malfalf/BenchBudEE/BenchBudEE/BOM/BenchBudEE_BOM_Actives.xls

Sheet: Cost Target
Part Index | Section | Device | 2nd | MFG | MFG Part Number | Quantity | 1 piece price | DK Link |  | 1 | 100 | 1000
1 | Current/Fan | Power/Mode FET | y | Alpha And Omega | AOD476 | 2 | $0.54 | http://www.digikey.com/product-detail/en/AOD476/785-1112-1-ND/1856055
1 | Current/Fan | Power/Mode FET | y | Fairchild Semiconductor | FDD6630A | 2 | $0.84 | http://www.findchips.com/search/FDD6630A
2 | Current/Fan | Signal FET | y | Diodes Inc | DMN65D8L-7 | 1 | $0.06 | http://www.digikey.com/product-detail/en/DMN65D8L-7/DMN65D8L-7DICT-ND/3677916
2 | Current/Fan | Signal FET | y | ST Micro | 2N7002 | 1 | $0.04 | http://www.findchips.com/search/2N7002#2953375
3 | Current/Fan | PTC |  | TE Connectivity | MINISMDC050F-2 | 1 | $0.31 | http://www.digikey.com/product-detail/en/MINISMDC050F-2/MINISMDC050FCT-ND/1045862
4 | Current/Fan | MCP4801 |  | Microchip | MCP4801-E/SN |  | $1.36 | http://www.digikey.com/product-detail/en/MCP4801-E%2FSN/MCP4801-E%2FSN-ND/2332805
5 | Interface | 3 pin 5.0mm Terminal Block |  | Phoenix Contact | 1935174 | 1 | $0.50 | http://www.digikey.com/product-detail/en/1935174/277-1578-ND/568615 | Power Modify | $9.64 | $2.08 | $2.55
6 | Interface | 12 input 3.5 mm Terminal Block | y | On Shore | OSTTE120104 | 1 | $1.57 | http://www.digikey.com/product-detail/en/OSTTE120104/ED2737-ND/2351813
6 | Interface | 12 input 3.5 mm Terminal Block | y | Phoenix Contact | 1984714 | 1 | $2.20 | http://www.findchips.com/search/1984714
7 | Interface | ATX connector |  | Molex | 39-30-1240 | 1 | $3.56 | http://www.mouser.com/ProductDetail/Molex/39-30-1240/ | Slush | $3.19 | $30.62 | $300.77
8 | Interface | 36 pin Breakaway | y | Molex | 22284360 | 1 | $0.89 | http://www.digikey.com/product-detail/en/0022284360/WM50014-36-ND/313821
9 | LED | AP5726 |  | Diodes Inc | AP5726WG-7 | 1 | $0.64 | http://www.digikey.com/product-detail/en/AP5726WG-7/AP5726WG-7DICT-ND/2639342
10 | LED | B0540WS-7 |  | Diodes Inc | B0540WS-7 | 1 | $0.45 | http://www.digikey.com/product-search/en?x=0&y=0&lang=en&site=us&KeyWords=B0540WS
11 | LED | NR4012T220M |  | Toiyo Yuden | NR4012T220M | 1 | $0.40 | http://www.digikey.com/product-detail/en/NR4012T220M/587-1660-1-ND/1008275
12 | Power Modify | 10V linear | y | On Semiconductor | LM317TG | 2 | $0.57 | http://www.digikey.com/product-detail/en/LM317TG/LM317TGOS-ND/918508
12 | Power Modify | 10V linear | y | On Semiconductor | LM317MTG | 2 | $0.64 | http://www.findchips.com/search/LM317MTG
13 | Power Modify | -10V linear | y | Fairchild Semiconductor | LM337TFS | 2 | $0.71 | http://www.digikey.com/product-detail/en/LM337T/LM337TFS-ND/458683
13 | Power Modify | -10V linear | y | Fairchild Semiconductor | LM337BTG | 2 | $0.71 | http://www.findchips.com/search/LM337BTG
16 | Power Modify | Potentiometer | y* | Panasonic Electric Components | EVU-E3KFK4B53 | 2 | $1.00 | http://www.digikey.com/product-detail/en/EVU-E3KFK4B53/P3W1502-ND/243676
16 | Power Modify | Potentiometer | y* | Bournes Inc | 3310C-1-502L | 2 | $2.35 | http://www.findchips.com/search/3310C-1-502L
17 | Power Modify | Diode |  | Diodes Inc | S1M-13-F | 4 | $0.15 | http://www.digikey.com/product-detail/en/S1M-13-F/S1M-FDICT-ND/804909
18 | Protection/Filtering | PTC |  | TE Connectivity | MINISMDC050F-2 | 4 | $0.31 | www.digikey.com/product-detail/en/MINISMDC050F-2/MINISMDC050FCT-ND/1045862
19 | Protection/Filtering | Inductor |  | Bournes Inc | CM322522-220KL | 2 | $0.22 | http://www.digikey.com/product-detail/en/CM322522-220KL/CM322522-220KLCT-ND/3437950
20 | Protection/Filtering | Switch |  | C&K Components | OS102011MA1QN1 | 1 | $0.35 | http://www.digikey.com/product-detail/en/OS102011MA1QN1/CKN9559-ND/1981430
21 | Relay | SPDT | y | TE Connectivity | 1461069-5 | 1 | $1.15 | http://www.digikey.com/product-detail/en/1461069-5/PB1321-ND/3318145 | LED | $1.49 | $0.92 | $0.52
21 | Relay | SPDT | y | OMRON | G5LA-1 12DC | 1 | $0.70 | http://www.findchips.com/search/G5LA-1%2012DC
22 | Relay | NPN (MMBT3904) |  | Diodes Inc | MMBT3904-7-F | 1 | $0.12 | http://www.digikey.com/product-detail/en/MMBT3904-7-F/MMBT3904-FDICT-ND/815727
23 | Relay | Opto | y | Lite On Ince | LTV-816S | 1 | $0.39 | www.digikey.com/product-detail/en/LTV-816S/160-1361-5-ND/385831
23 | Relay | Opto | y | Lite On Ince | ACPL-217-500E | 1 |  | http://www.findchips.com/search/ACPL-217-500E
24 | Relay | B130-13-F |  | Diodes Inc | B130-13-F | 1 | $0.43 | http://www.digikey.com/product-detail/en/B130-13-F/B130-FDICT-ND/815318
25 | Relay | LED | y | OSRAM Opto | LG Q971-KN-1 | 1 | $0.08 | http://www.digikey.com/product-detail/en/LG%20Q971-KN-1/475-1409-1-ND/1802597
25 | Relay | LED | y | Kingbright | KP-1608CGCK | 1 | $0.16 | http://www.findchips.com/search/KP-1608CGCK
26 | TC/Analog | MCP3901 |  | Microchip | MCP3901A0-I/SS | 1 | $2.39 | http://www.digikey.com/product-detail/en/MCP3901A0-I%2FSS/MCP3901A0-I%2FSS-ND/2179119 | Total | $14.84 | $5.79 | $6.62
27 | TC/Analog | OPA4170 | y | Texas Instruments | OPA4170AIDR | 1 | $2.58 | http://www.digikey.com/product-detail/en/OPA4170AIDR/296-29664-1-ND/2762167 | TC/Analog | $2.39 | $1.51 | $1.51
27 | TC/Analog | OPA4170 | y | Texas Instruments | OPA4170AID | 1 | $2.58 | http://www.findchips.com/search/OPA4170AID
28 | TC/Analog | LMT84 |  | Texas Instruments | LMT84DCKT | 1 | $0.73 | http://www.digikey.com/product-detail/en/LMT84DCKT/296-35727-2-ND/3974441 | Current/Fan | $1.45 | $0.94 | $0.57
29 | TC/Analog | .1% 20K, 1206 | y | Susumu | RG3216P-2002-B-T1 | 4 | $0.65 | http://www.digikey.com/product-search/en?v=408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 | Relay | $2.17 | $1.21 | $0.82
29 | TC/Analog | .1% 10K, 1206 | y | Susumu | CRT1206-BY-1002ELF | 4 |  | http://www.findchips.com/search/CRT1206-BY-1002ELF
30 | TC/Analog | Shunt/Jumper |  | 3M | 969102-0000-DA | 3 | $0.10 | http://www.digikey.com/product-detail/en/969102-0000-DA/3M9580-ND/2071621 | General | $0.00 | $0.00 | $0.00
31 | Power Modify | Heatsink | y | Assmann | V8508H | 2 | $0.58 | http://www.digikey.com/product-search/en?vendor=0&keywords=V8508H
31 | Power Modify | Heatsink | y | Multicomp | MC33282 | 2 | $1.25 | http://www.findchips.com/search/MC33282

Sheet: Design Constraints
Index | Constraint | Reason
1 | Parts not too expensive in low quantity
2 | Solderable components
3 | Multiple parts for the footprint/available parts | Worldwide people
4 | No Throughhole
5 | Low lead time | Time constrained
6 | No more than a 4 layer board, prefer 2
7 | Board no bigger than 3x4
8 | Board can be stackable
9 | Maintain Arduino constraints (clock,power,pins)
