malfalf/BenchBudEE/BenchBudEE/BenchBudEE.kicad_pcb

## KiCad design BenchBudEE/BenchBudEE.kicad_pcb (2014-03-31)

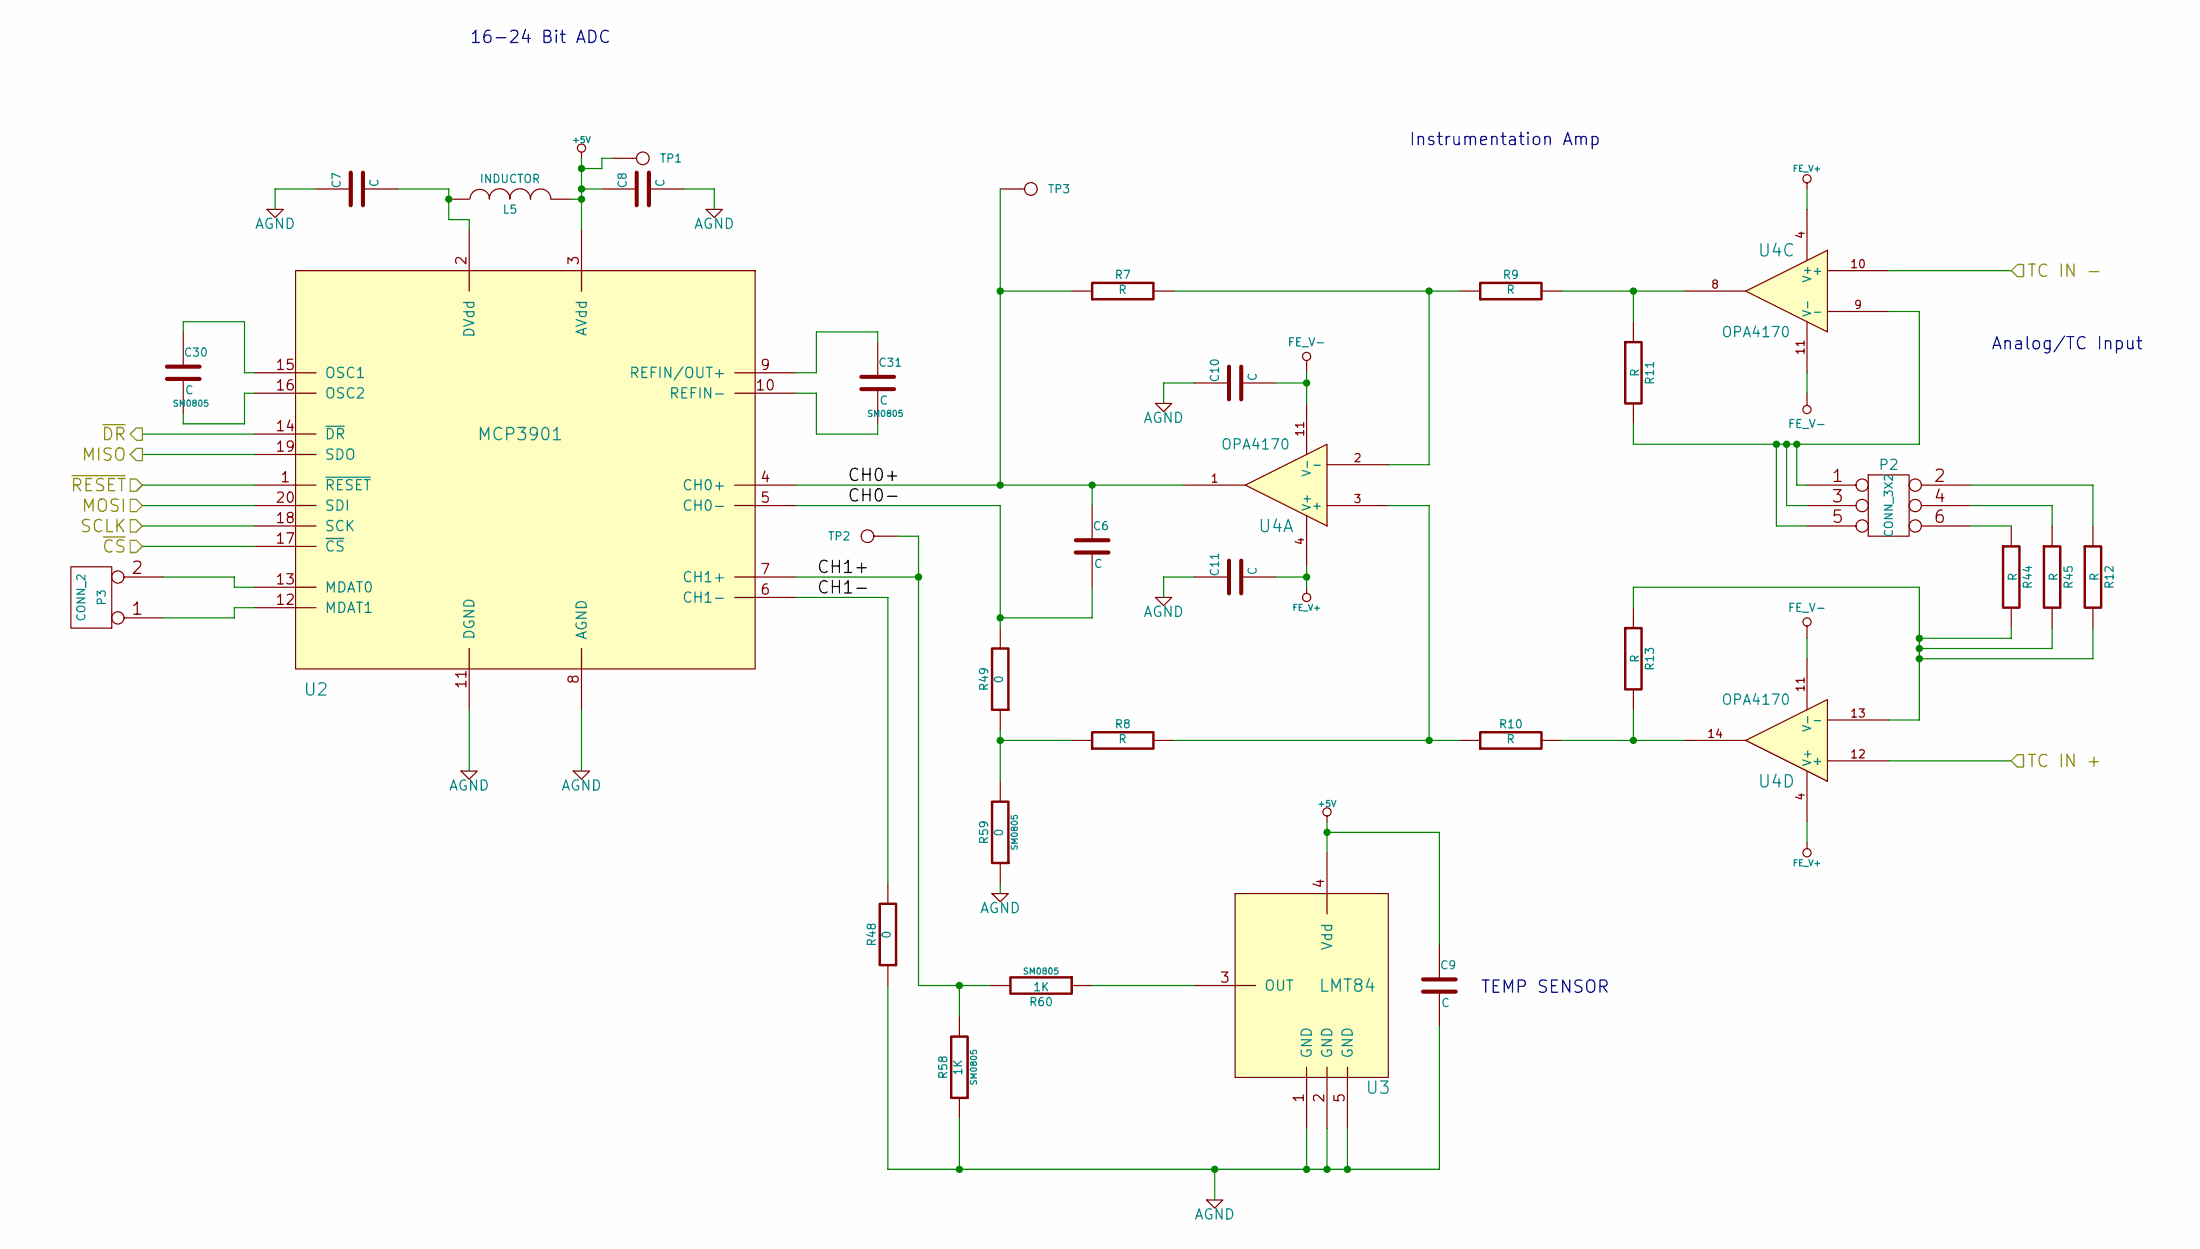
[picture p1: schematic Thermocouple.sch]

Parts:
C6, C7, C8, C9, C10, C11: C
C30, C31: C; SM0805
L5: INDUCTOR
P2: CONN_3X2
P3: CONN_2
R7, R8, R9, R10, R11, R12, R13, R44, R45: R
R48, R49: 0
R58, R60: 1K; SM0805
R59: 0; SM0805
TP1: 5V
TP2: CH1+
TP3: CH0+
U2: MCP3901
U3: LMT84
U4: OPA4170

Connections:
+5V: C8.1, C9.1, L5.2, TP1.1, U2.3 (AVdd), U3.4 (Vdd); also elsewhere on the board
/Arduino/MISO: U2.19 (SDO); also elsewhere on the board
/Arduino/MOSI: U2.20 (SDI); also elsewhere on the board
/Arduino/SCLK: U2.18 (SCK); also elsewhere on the board
/Arduino/~ADC_CS: U2.17 (~CS); also elsewhere on the board
/Arduino/~DR: U2.14 (~DR); also elsewhere on the board
/Arduino/~RESET: U2.1 (~RESET); also elsewhere on the board
/Thermocouple/CH0+: C6.1, R7.1, TP3.1, U2.4 (CH0+), U4.1
/Thermocouple/CH0-: C6.2, R49.2, U2.5 (CH0-)
/Thermocouple/CH1+: R58.2, R60.2, TP2.1, U2.7 (CH1+)
/Thermocouple/CH1-: R48.2, U2.6 (CH1-)
/Thermocouple/TC IN +: U4.12 (+); also elsewhere on the board
/Thermocouple/TC IN -: U4.10 (+); also elsewhere on the board
AGND: C7.1, C8.2, C9.2, C10.1, C11.1, R48.1, R58.1, R59.1, U2.8 (AGND), U2.11 (DGND), U3.1 (GND), U3.2 (GND), U3.5 (GND); also elsewhere on the board
FE_V+: C11.2, U4.4 (V+); also elsewhere on the board
FE_V-: C10.2, U4.11 (V-); also elsewhere on the board
unnamed: C7.2, L5.1, U2.2 (DVdd)
unnamed: C30.1, U2.15 (OSC1)
unnamed: R60.1, U3.3 (OUT)
unnamed: C30.2, U2.16 (OSC2)
unnamed: C31.2, U2.10 (REFIN-)
unnamed: P2.4, R45.1
unnamed: P2.6, R44.1
unnamed: R8.2, R10.1, U4.3 (+)
unnamed: R7.2, R9.1, U4.2 (-)
unnamed: P2.2, R12.1
unnamed: R9.2, R11.1, U4.8
unnamed: R10.2, R13.2, U4.14
unnamed: P3.2 (PM), U2.13 (MDAT0)
unnamed: P3.1, U2.12 (MDAT1)
unnamed: C31.1, U2.9 (REFIN/OUT+)
unnamed: R8.1, R49.1, R59.2
unnamed: R12.2, R13.1, R44.2, R45.2, U4.13 (-)
unnamed: P2.1, P2.3, P2.5, R11.2, U4.9 (-)

Notes on the sheet:
Analog/TC Input
Instrumentation Amp
16-24 Bit ADC
TEMP SENSOR

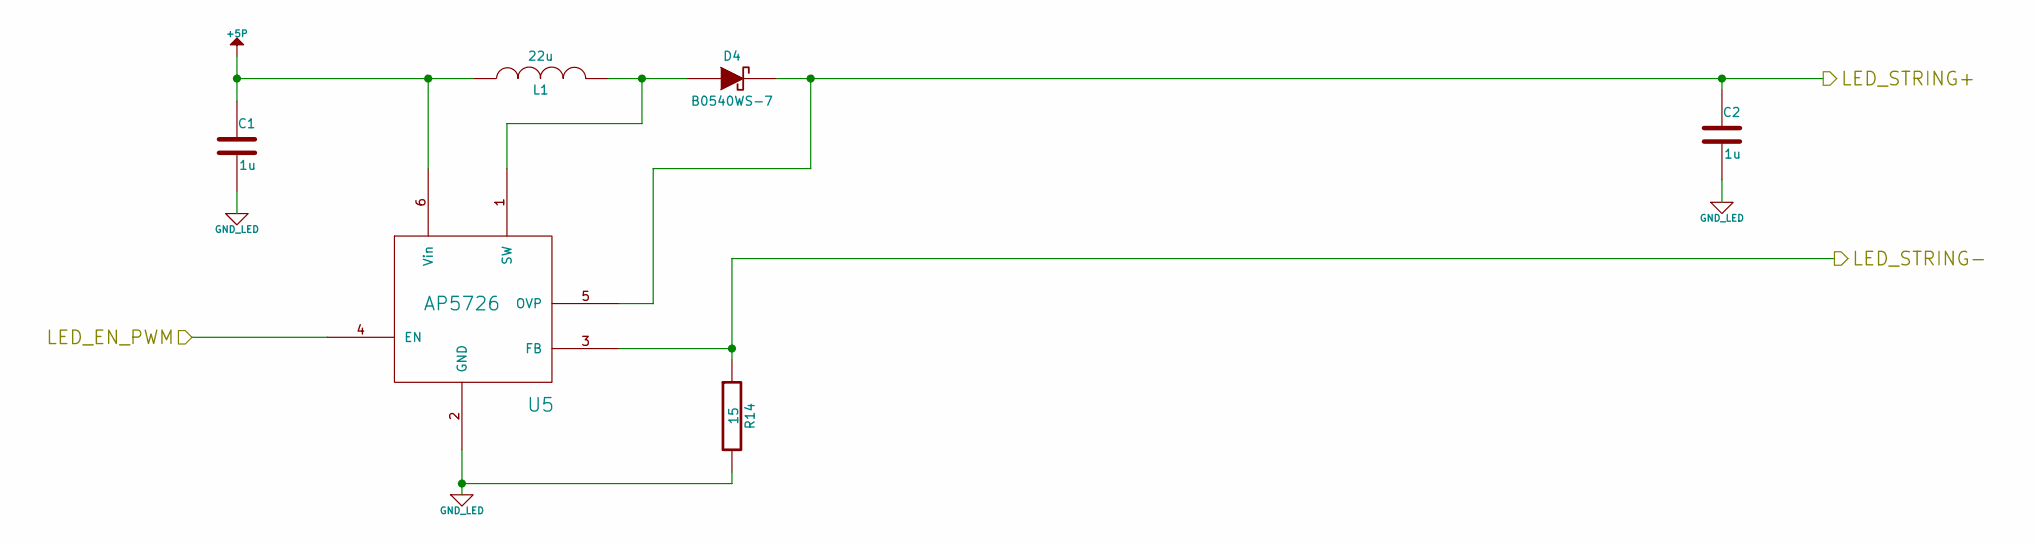
[picture p2: schematic LED_Driver.sch]

Parts:
C1, C2: 1u
D4: B0540WS-7
L1: 22u; MFG Part Number NR4012T220M
R14: 15
U5: AP5726

Connections:
+5P: C1.1, L1.1, U5.6 (Vin); also elsewhere on the board
/Arduino/LED_EN_PWM: U5.4 (EN); also elsewhere on the board
/LED_Driver/LED_STRING+: C2.1, D4.2 (K), U5.5 (OVP); also elsewhere on the board
/LED_Driver/LED_STRING-: R14.1, U5.3 (FB); also elsewhere on the board
GND_LED: C1.2, C2.2, R14.2, U5.2 (GND); also elsewhere on the board
unnamed: D4.1 (A), L1.2, U5.1 (SW)

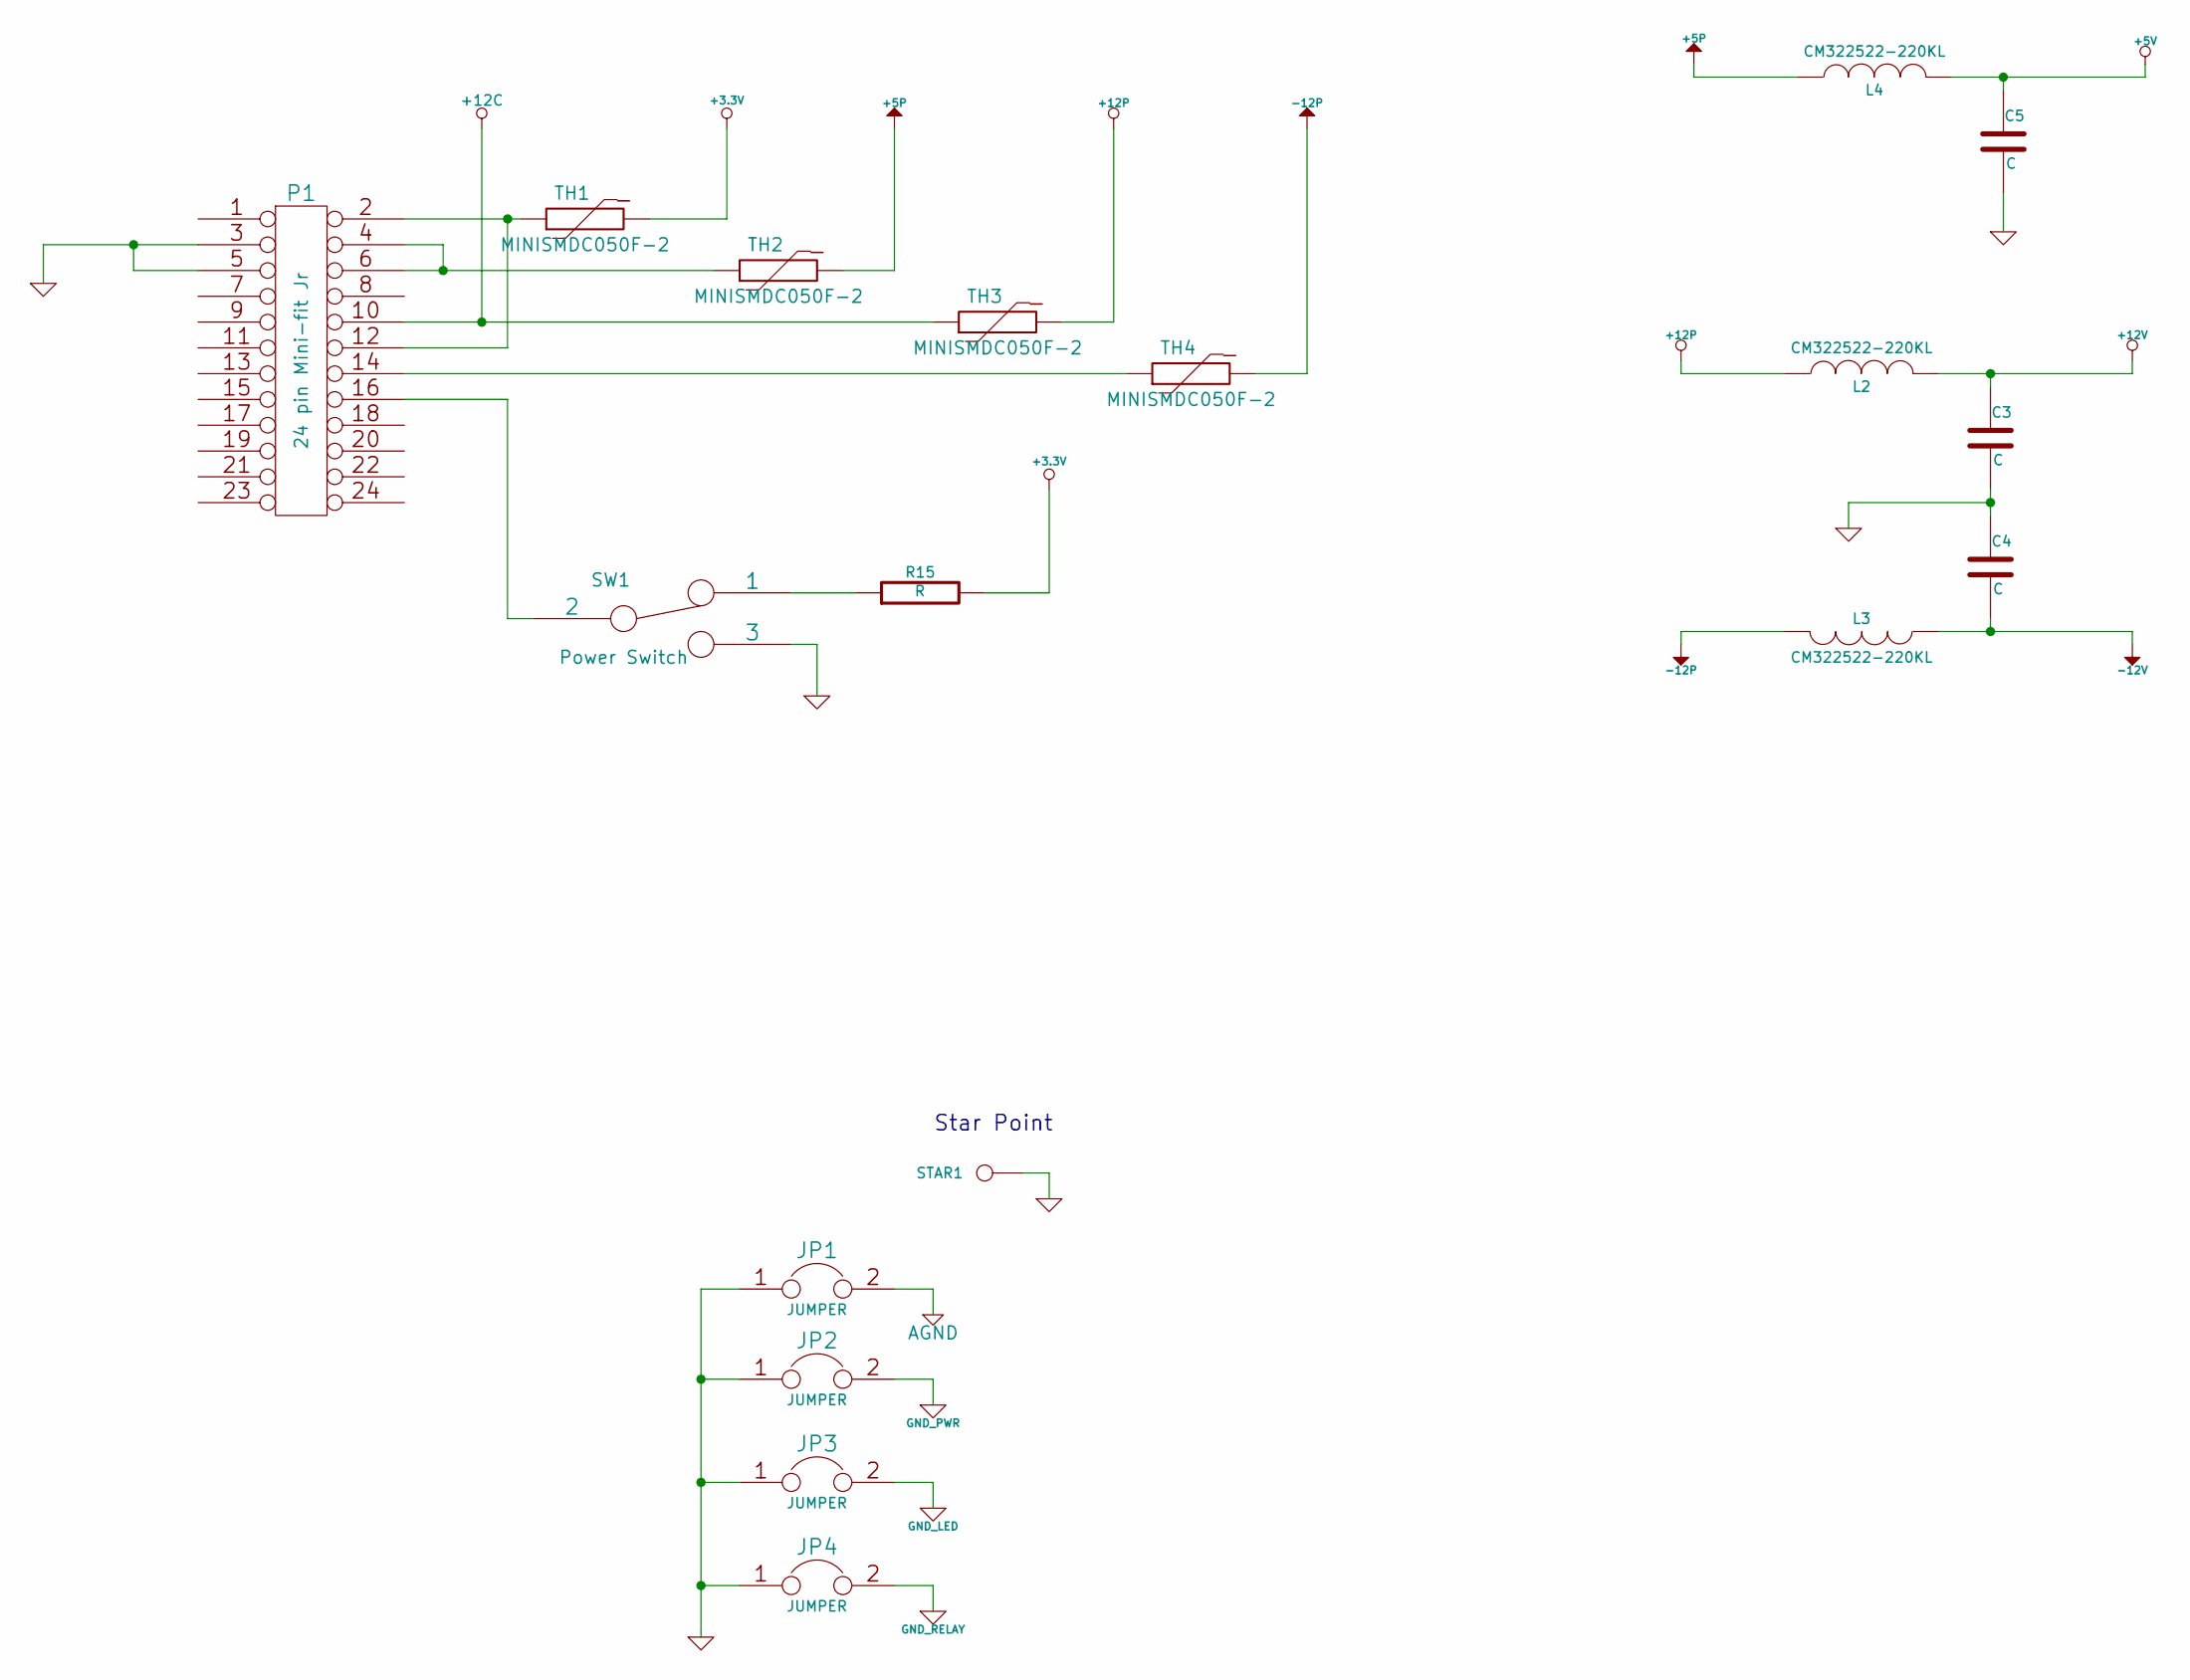
[picture p3: schematic Power.sch]

Parts:
C3, C4, C5: C
JP1, JP2, JP3, JP4: JUMPER
L2, L3, L4: CM322522-220KL; MFG Part Number CM322522-220KL
P1: 24 pin Mini-fit Jr; MFG Part Number 39-30-1240
R15: R
STAR1: CONN_1
SW1: Power Switch; MFG Part Number OS102011MA1QN1
TH1, TH2, TH3, TH4: MINISMDC050F-2; MFG Part Number MINISMDC050F-2

Connections:
+3.3V: R15.2, TH1.2; also elsewhere on the board
+5P: L4.1, TH2.2; also elsewhere on the board
+5V: C5.1, L4.2; also elsewhere on the board
+12C: P1.10, TH3.1; also elsewhere on the board
+12P: L2.1, TH3.2; also elsewhere on the board
+12V: C3.1, L2.2; also elsewhere on the board
-12P: L3.2, TH4.2
-12V: C4.2, L3.1; also elsewhere on the board
AGND: JP1.2; also elsewhere on the board
GND: C3.2, C4.1, C5.2, JP1.1, JP2.1, JP3.1, JP4.1, P1.3, P1.5, STAR1.1, SW1.3; also elsewhere on the board
GND_LED: JP3.2; also elsewhere on the board
GND_PWR: JP2.2; also elsewhere on the board
GND_RELAY: JP4.2; also elsewhere on the board
unnamed: P1.14, TH4.1
unnamed: P1.16, SW1.2
unnamed: P1.4, P1.6, TH2.1
unnamed: R15.1, SW1.1
unnamed: P1.2, P1.12, TH1.1

Notes on the sheet:
Star Point

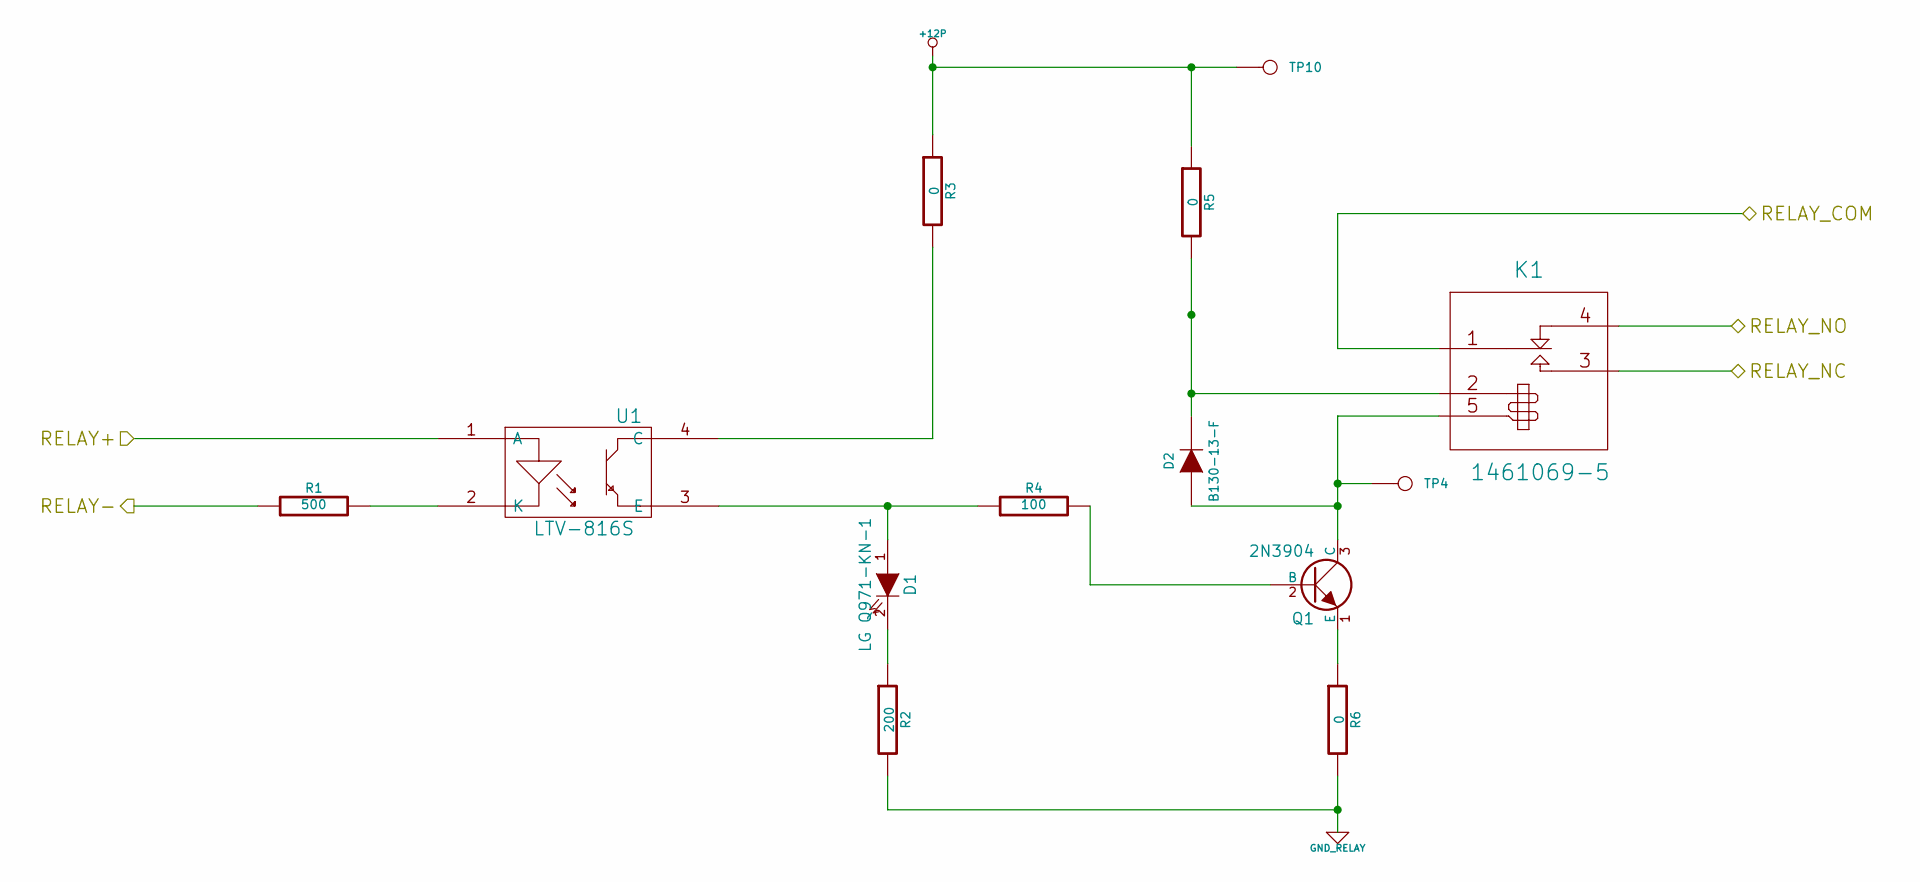
[picture p4: schematic Relay.sch]

Parts:
D1: LG Q971-KN-1
D2: B130-13-F
K1: 1461069-5
Q1: 2N3904; MFG Part Number MMBT3904-7-F
R1: 500
R2: 200
R3, R5, R6: 0
R4: 100
TP4: RELAY_LOW
TP10: 12P
U1: LTV-816S; MFG Part Number LTV-816S

Connections:
+12P: R3.1, R5.1, TP10.1; also elsewhere on the board
/Arduino/RELAY+: U1.1 (A); also elsewhere on the board
/Arduino/RELAY-: R1.1; also elsewhere on the board
/Relay/RELAY_COM: K1.1 (COM); also elsewhere on the board
/Relay/RELAY_NC: K1.3 (NO); also elsewhere on the board
/Relay/RELAY_NO: K1.4 (NC); also elsewhere on the board
GND_RELAY: R2.2, R6.2; also elsewhere on the board
unnamed: D1.2 (K), R2.1
unnamed: Q1.1 (E), R6.1
unnamed: D1.1 (A), R4.1, U1.3 (E)
unnamed: Q1.2 (B), R4.2
unnamed: R1.2, U1.2 (K)
unnamed: D2.2 (K), K1.2 (COIL+), R5.2
unnamed: R3.2, U1.4 (C)
unnamed: D2.1 (A), K1.5 (COIL-), Q1.3 (C), TP4.1

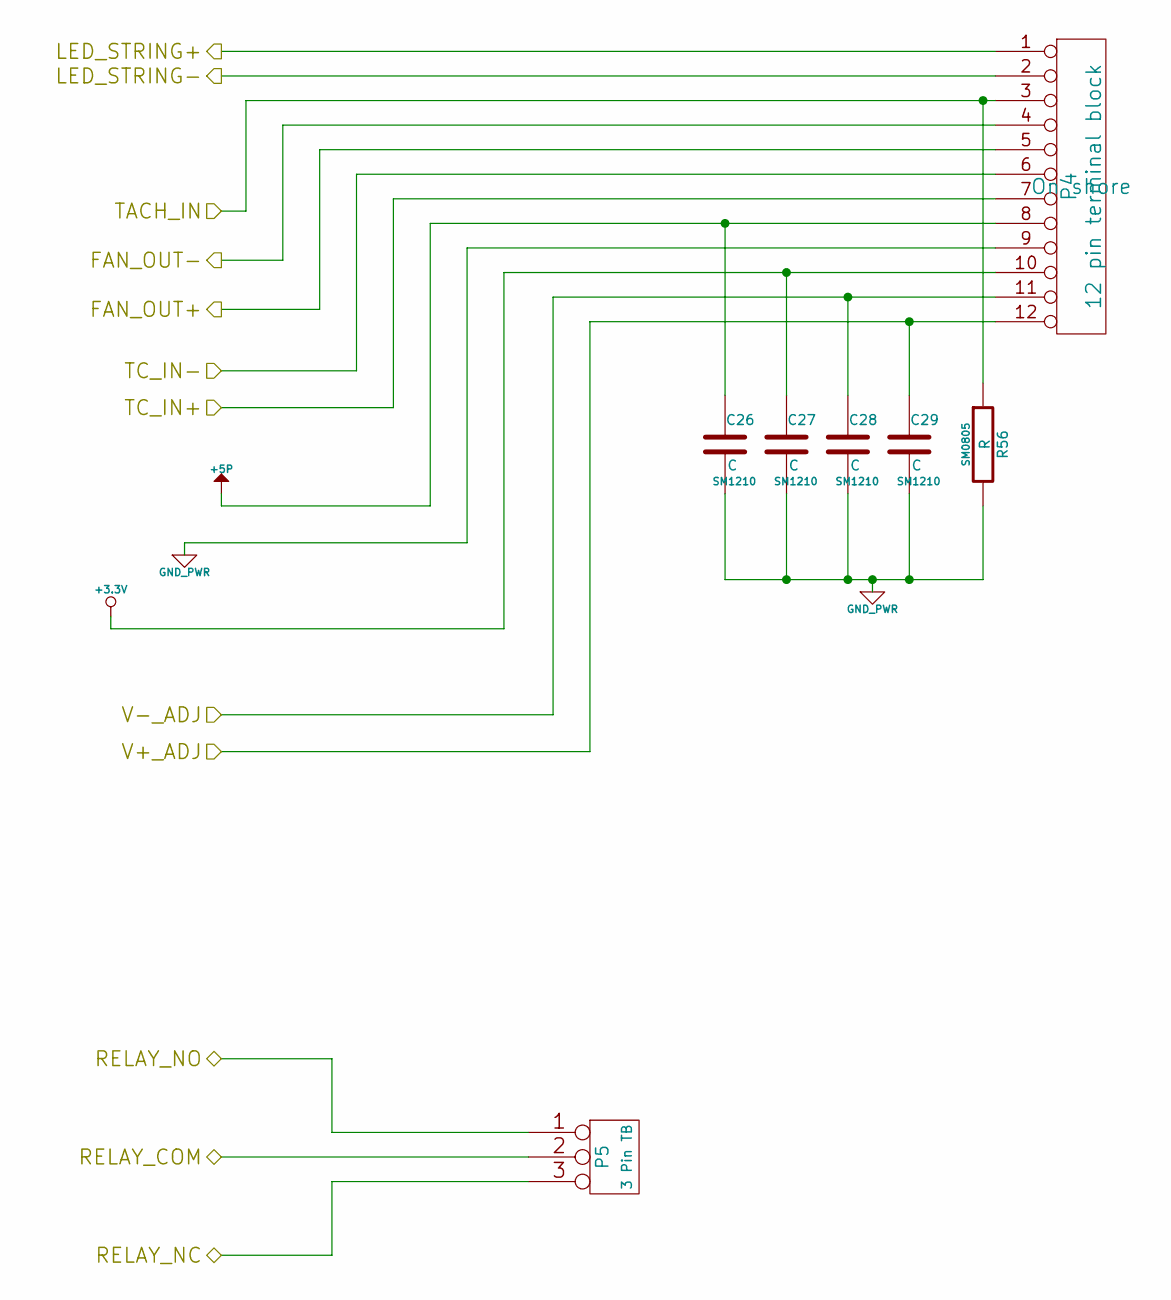
[picture p5: schematic TerminalBlock.sch]

Parts:
C26, C27, C28, C29: C; SM1210
P4: 12 pin terminal block; MFG Part Number OSTTE120104
P5: 3 Pin TB; MFG Part Number 1935174
R56: R; SM0805

Connections:
+3.3V: C27.1, P4.10; also elsewhere on the board
+5P: C26.1, P4.8; also elsewhere on the board
/Fan/FAN_OUT+: P4.5; also elsewhere on the board
/Fan/FAN_OUT-: P4.4; also elsewhere on the board
/Fan/TACH_IN: P4.3, R56.1; also elsewhere on the board
/LED_Driver/LED_STRING+: P4.1; also elsewhere on the board
/LED_Driver/LED_STRING-: P4.2; also elsewhere on the board
/PowerAdjustmentMonitor/V+_ADJ: C29.1, P4.12; also elsewhere on the board
/PowerAdjustmentMonitor/V-_ADJ: C28.1, P4.11; also elsewhere on the board
/Relay/RELAY_COM: P5.2 (PM); also elsewhere on the board
/Relay/RELAY_NC: P5.3; also elsewhere on the board
/Relay/RELAY_NO: P5.1; also elsewhere on the board
/Thermocouple/TC IN +: P4.7; also elsewhere on the board
/Thermocouple/TC IN -: P4.6; also elsewhere on the board
GND_PWR: C26.2, C27.2, C28.2, C29.2, P4.9, R56.2; also elsewhere on the board

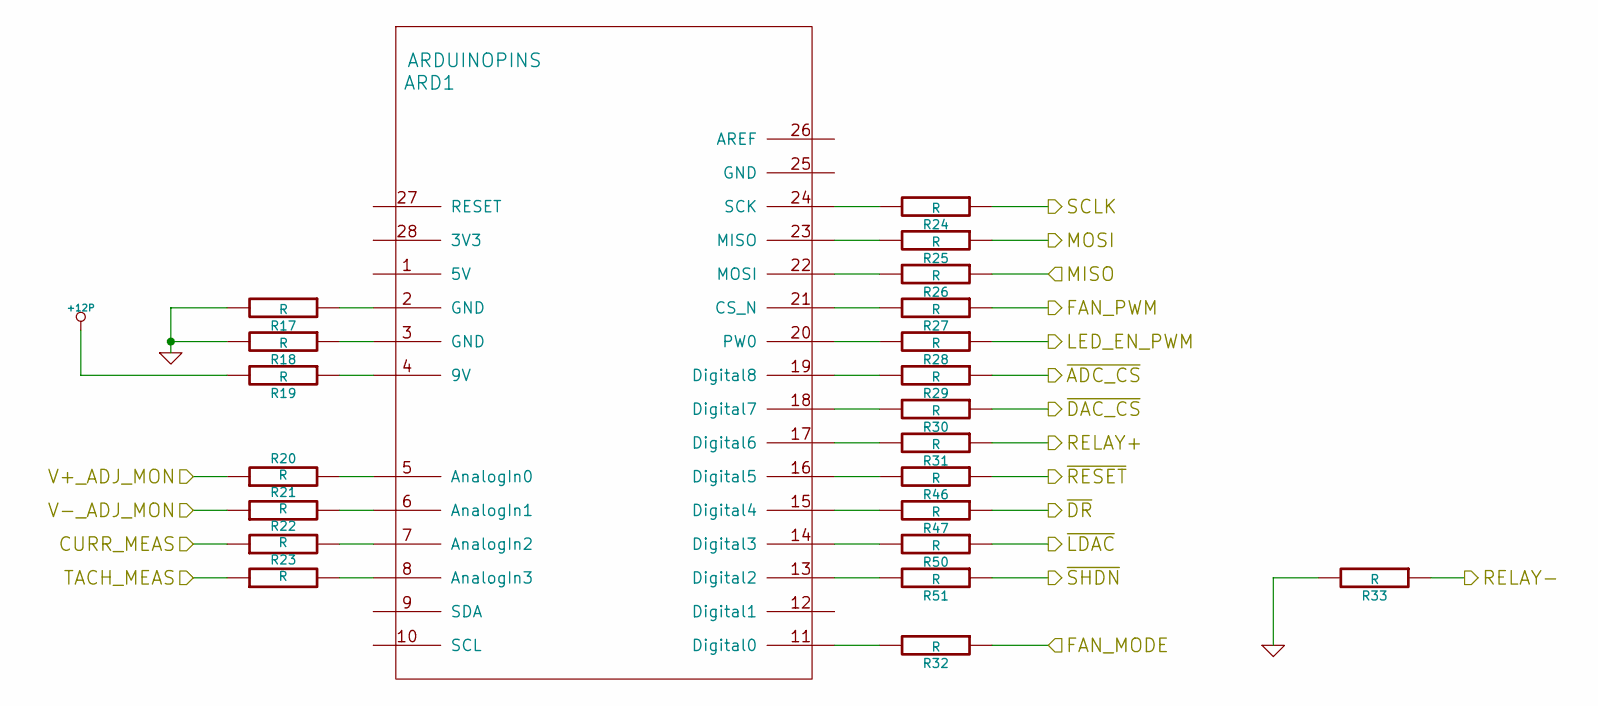
[picture p6: schematic Arduino.sch]

Parts:
ARD1: ARDUINOPINS
R17, R18, R19, R20, R21, R22, R23, R24, R25, R26, R27, R28, R29, R30, R31, R32, R33, R46, R47, R50, R51: R

Connections:
+12P: R19.2; also elsewhere on the board
/Arduino/CURR_MEAS: R22.1; also elsewhere on the board
/Arduino/FAN_MODE: R32.1; also elsewhere on the board
/Arduino/FAN_PWM: R27.1; also elsewhere on the board
/Arduino/LED_EN_PWM: R28.1; also elsewhere on the board
/Arduino/MISO: R26.1; also elsewhere on the board
/Arduino/MOSI: R25.1; also elsewhere on the board
/Arduino/RELAY+: R31.1; also elsewhere on the board
/Arduino/RELAY-: R33.1; also elsewhere on the board
/Arduino/SCLK: R24.1; also elsewhere on the board
/Arduino/V+_ADJ_MON: R20.1; also elsewhere on the board
/Arduino/V-_ADJ_MON: R21.1; also elsewhere on the board
/Arduino/~ADC_CS: R29.1; also elsewhere on the board
/Arduino/~DR: R47.1; also elsewhere on the board
/Arduino/~LDAC: R50.1; also elsewhere on the board
/Arduino/~RESET: R46.1; also elsewhere on the board
/Fan/CS_N: R30.1; also elsewhere on the board
/Fan/TACH_IN: R23.1; also elsewhere on the board
/Fan/~SDHN: R51.1; also elsewhere on the board
GND: R17.2, R18.2, R33.2; also elsewhere on the board
unnamed: ARD1.11 (Digital0), R32.2
unnamed: ARD1.15 (Digital4), R47.2
unnamed: ARD1.17 (Digital6), R31.2
unnamed: ARD1.4 (9V), R19.1
unnamed: ARD1.16 (Digital5), R46.2
unnamed: ARD1.14 (Digital3), R50.2
unnamed: ARD1.13 (Digital2), R51.2
unnamed: ARD1.2 (GND), R17.1
unnamed: ARD1.3 (GND), R18.1
unnamed: ARD1.7 (AnalogIn2), R22.2
unnamed: ARD1.8 (AnalogIn3), R23.2
unnamed: ARD1.6 (AnalogIn1), R21.2
unnamed: ARD1.5 (AnalogIn0), R20.2
unnamed: ARD1.21 (CS_N), R27.2
unnamed: ARD1.20 (PW0), R28.2
unnamed: ARD1.19 (Digital8), R29.2
unnamed: ARD1.18 (Digital7), R30.2
unnamed: ARD1.22 (MOSI), R26.2
unnamed: ARD1.23 (MISO), R25.2
unnamed: ARD1.24 (SCK), R24.2

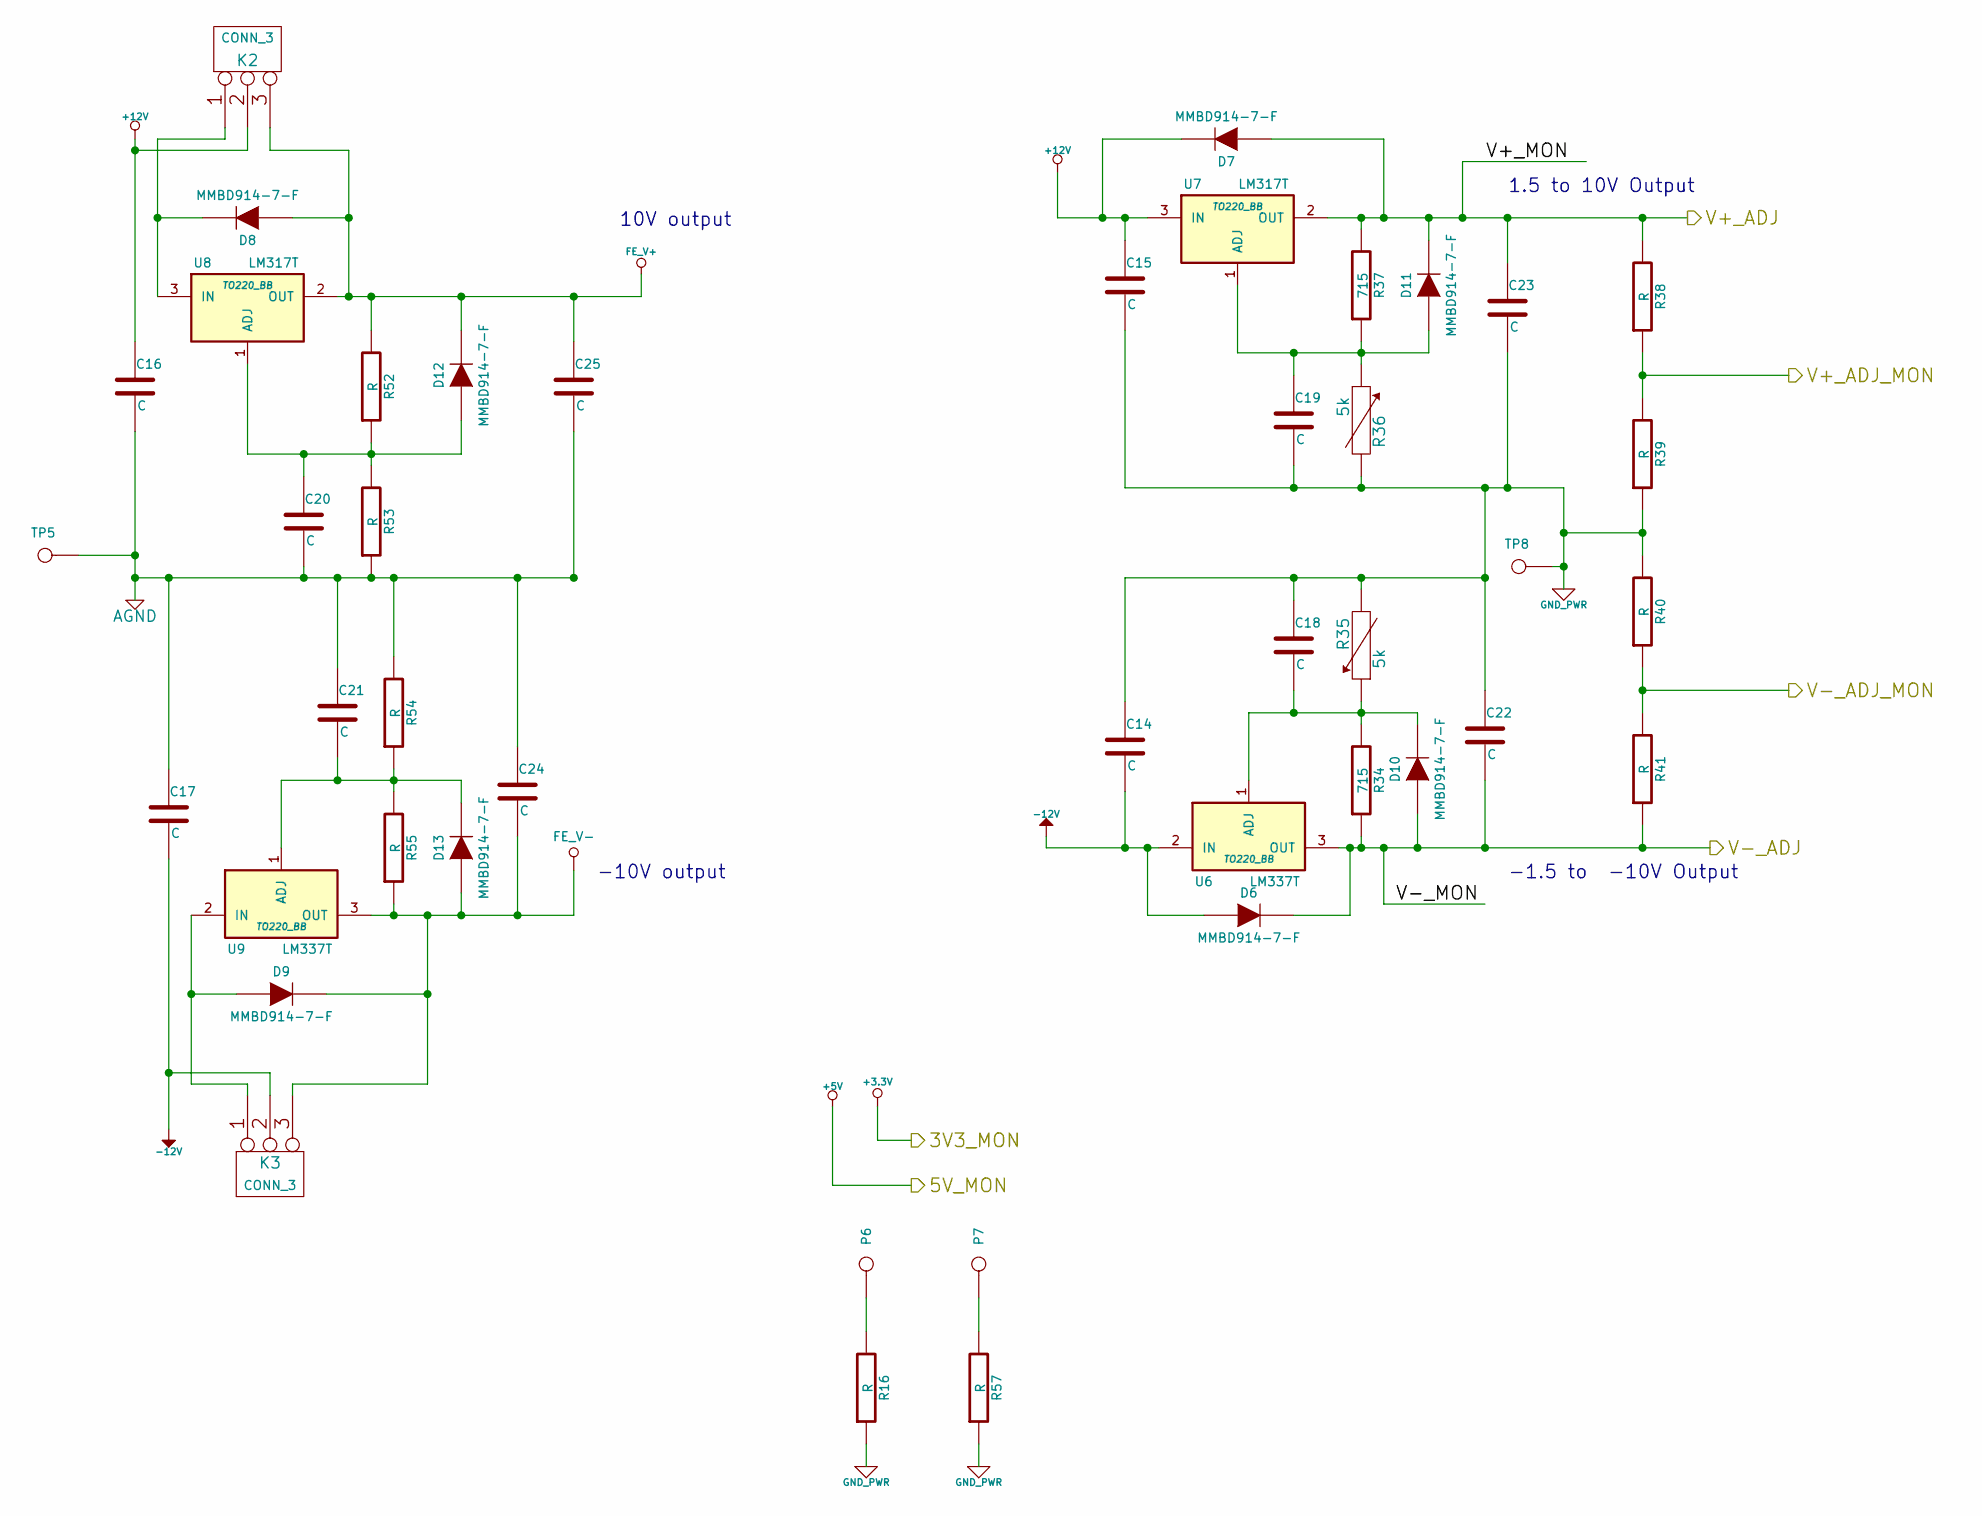
[picture p7: schematic PowerAdjustmentMonitor.sch]

Parts:
C14, C15, C16, C17, C18, C19, C20, C21, C22, C23, C24, C25: C
D6, D7, D8, D9, D10, D11, D12, D13: MMBD914-7-F
K2, K3: CONN_3
P6, P7: CONN_1
R16, R38, R39, R40, R41, R52, R53, R54, R55, R57: R
R34, R37: 715
R35, R36: 5k
TP5: AGND
TP8: GND_PWR
U6, U9: LM337T; TO220_BB
U7, U8: LM317T; TO220_BB

Connections:
+12V: C15.1, C16.1, D7.2 (K), K2.2 (PM), U7.3 (IN); also elsewhere on the board
-12V: C14.2, C17.2, D6.1 (A), K3.2 (PM), U6.2 (IN); also elsewhere on the board
/Arduino/V+_ADJ_MON: R38.1, R39.2; also elsewhere on the board
/Arduino/V-_ADJ_MON: R40.1, R41.2; also elsewhere on the board
/PowerAdjustmentMonitor/V+_ADJ: C23.1, D7.1 (A), D11.2 (K), R37.2, R38.2, U7.2 (OUT); also elsewhere on the board
/PowerAdjustmentMonitor/V-_ADJ: C22.2, D6.2 (K), D10.1 (A), R34.1, R41.1, U6.3 (OUT); also elsewhere on the board
AGND: C16.2, C17.1, C20.2, C21.1, C24.1, C25.2, R53.1, R54.2, TP5.1; also elsewhere on the board
FE_V+: C25.1, D8.1 (A), D12.2 (K), K2.3, R52.2, U8.2 (OUT); also elsewhere on the board
FE_V-: C24.2, D9.2 (K), D13.1 (A), K3.3, R55.1, U9.3 (OUT); also elsewhere on the board
GND_PWR: C14.1, C15.2, C18.1, C19.2, C22.1, C23.2, R16.1, R35.2, R36.2, R39.1, R40.2, R57.1, TP8.1; also elsewhere on the board
unnamed: D8.2 (K), K2.1, U8.3 (IN)
unnamed: P7.1, R57.2
unnamed: P6.1, R16.2
unnamed: D9.1 (A), K3.1, U9.2 (IN)
unnamed: C19.1, D11.1 (A), R36.1, R37.1, U7.1 (ADJ)
unnamed: C20.1, D12.1 (A), R52.1, R53.2, U8.1 (ADJ)
unnamed: C21.2, D13.2 (K), R54.1, R55.2, U9.1 (ADJ)
unnamed: C18.2, D10.2 (K), R34.2, R35.1, U6.1 (ADJ)

Notes on the sheet:
10V output
1.5 to 10V Output
-10V output
-1.5 to -10V Output
