malfalf/BenchBudEE/BenchBudEE/BenchBudEE.kicad_pcb

## KiCad design BenchBudEE/BenchBudEE.kicad_pcb (continued)

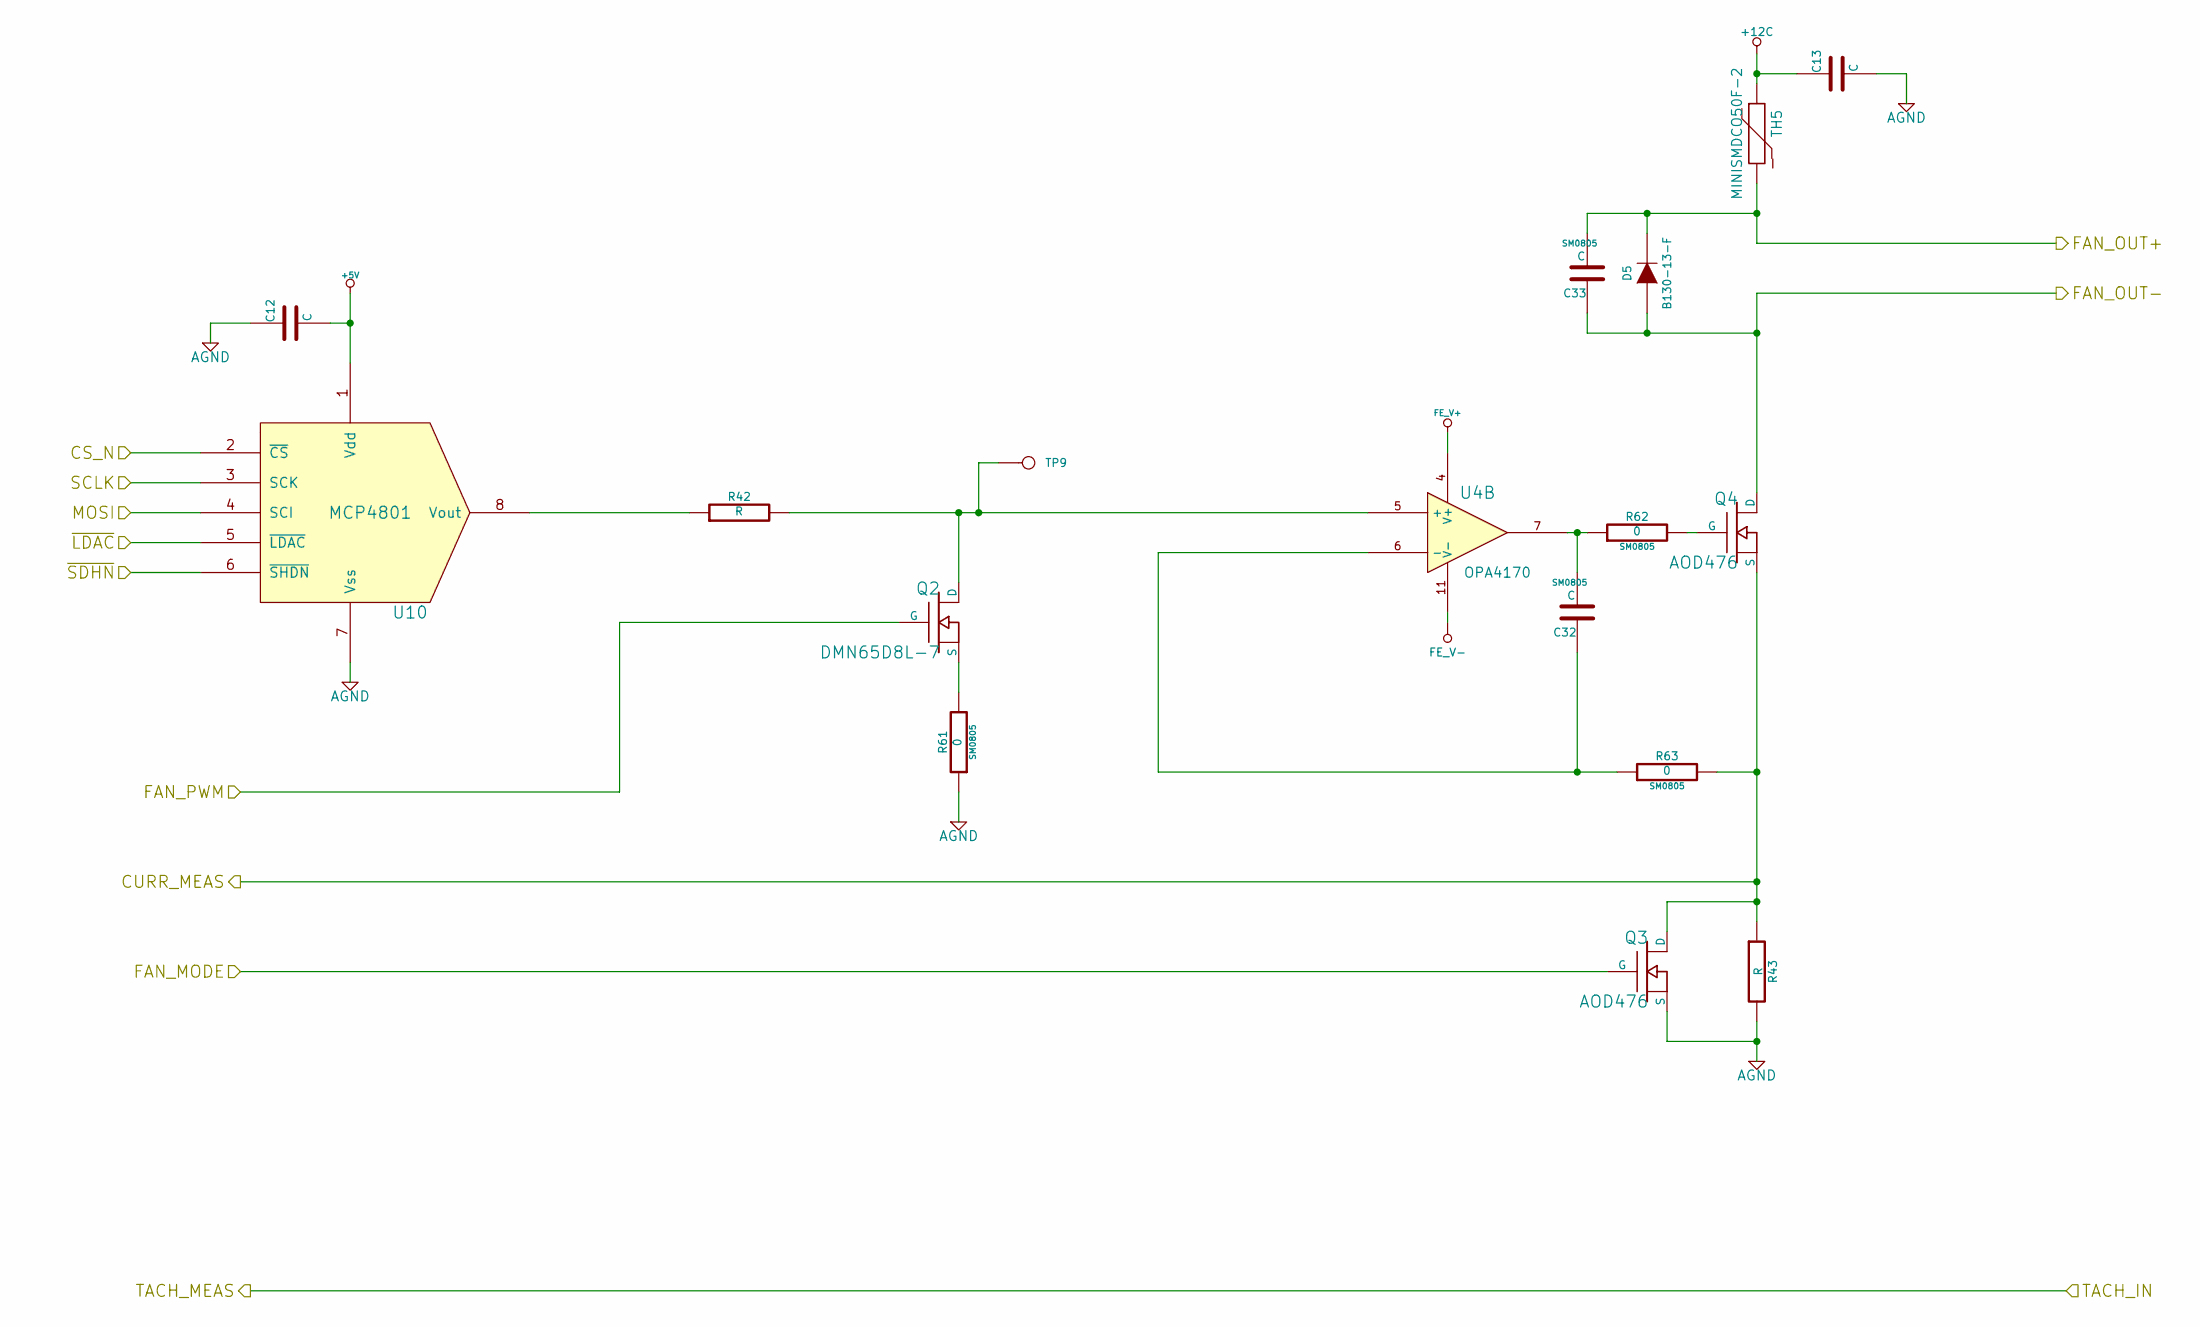
[picture p8: schematic Fan.sch]

Parts:
C12, C13: C
C32, C33: C; SM0805
D5: B130-13-F; MFG Part Number B130-13-F
Q2: DMN65D8L-7; MFG Part Number DMN65D8L-7
Q3, Q4: AOD476; MFG Part Number AOD476
R42, R43: R
R61, R62, R63: 0; SM0805
TH5: MINISMDCO50F-2; MFG Part Number MINISMDCO50F-2
TP9: DAC_OUT
U4: OPA4170
U10: MCP4801

Connections:
+5V: C12.2, U10.1 (Vdd); also elsewhere on the board
+12C: C13.1, TH5.1; also elsewhere on the board
/Arduino/CURR_MEAS: Q3.2 (D), Q4.3 (S), R43.1, R63.2; also elsewhere on the board
/Arduino/FAN_MODE: Q3.1 (G); also elsewhere on the board
/Arduino/FAN_PWM: Q2.G; also elsewhere on the board
/Arduino/MOSI: U10.4 (SCI); also elsewhere on the board
/Arduino/SCLK: U10.3 (SCK); also elsewhere on the board
/Arduino/~LDAC: U10.5 (~LDAC); also elsewhere on the board
/Fan/CS_N: U10.2 (~CS); also elsewhere on the board
/Fan/FAN_OUT+: C33.2, D5.2 (K), TH5.2; also elsewhere on the board
/Fan/FAN_OUT-: C33.1, D5.1 (A), Q4.2 (D); also elsewhere on the board
/Fan/~SDHN: U10.6 (~SHDN); also elsewhere on the board
AGND: C12.1, C13.2, Q3.3 (S), R43.2, R61.1, U10.7 (Vss); also elsewhere on the board
FE_V+: U4.4 (V+); also elsewhere on the board
FE_V-: U4.11 (V-); also elsewhere on the board
unnamed: R42.1, U10.8 (Vout)
unnamed: Q4.1 (G), R62.2
unnamed: C32.1, R63.1, U4.6 (-)
unnamed: Q2.3 (S), Q2.S, R61.2
unnamed: C32.2, R62.1, U4.7
unnamed: Q2.2 (D), Q2.D, R42.2, TP9.1, U4.5 (+)

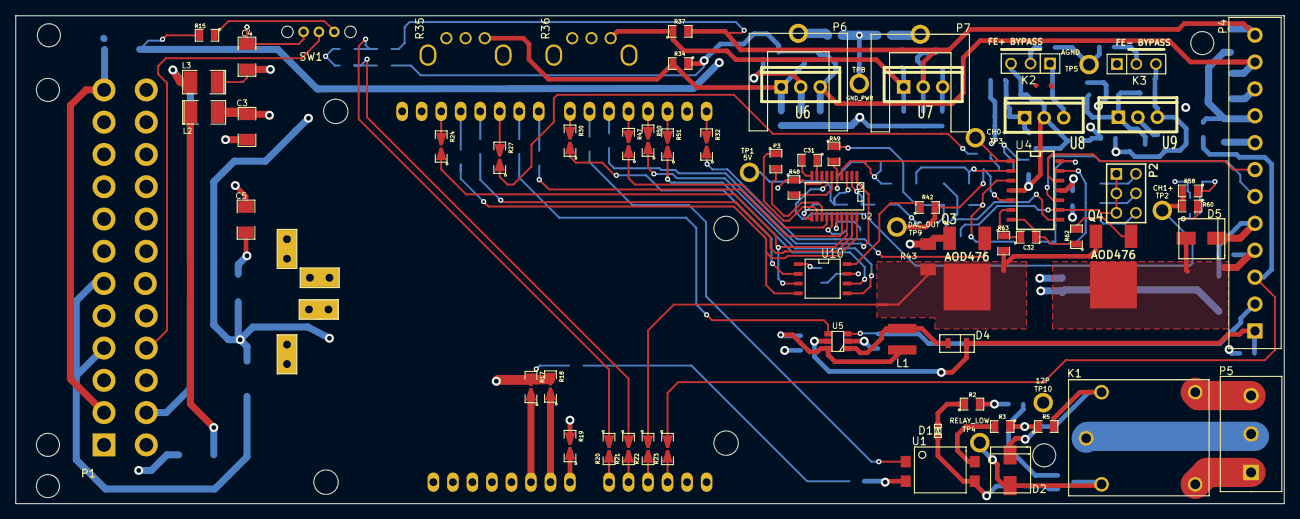
[picture p9: board BenchBudEE.kicad_pcb from above]

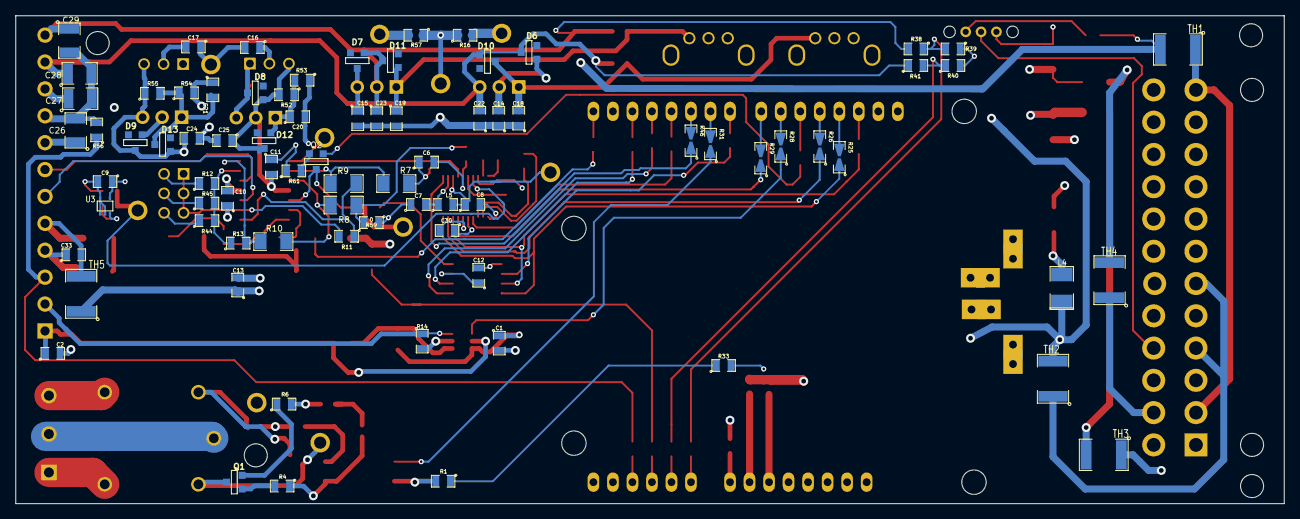
[picture p10: board BenchBudEE.kicad_pcb from below]

Board: 4 copper layers, 165.1 x 63.5 mm, 160 parts (79 on the bottom side), 114 nets.

Other parts of the board:
3 mm, 3 mm#2, 3 mm#3, 3 mm#4: VAL**; 3mm-NPTH
