malfalf/BenchBudEE/(commit log)

2014-01-30 New KiCAD project
    Blank schematic and layout file.
    [BenchBudEE.kicad_pcb, BenchBudEE.sch]
2014-02-01 Block Diagram and hierarchy blocks created
    [Arduino.sch, BenchBudEE.sch, Fan.sch, LED_Driver.sch, Power.sch, Relay.sch, TerminalBlock.sch, Thermocouple.sch]
2014-02-01 Inputs and Outputs added
    [Arduino.sch, BenchBudEE.sch, Fan.sch, LED_Driver.sch, Relay.sch, Thermocouple.sch]
2014-02-04 Thermocoupler Block diagram
    [Arduino.sch, BenchBudEE.sch, Fan.sch, LED_Driver.sch, Power.sch, Relay.sch, TerminalBlock.sch, Thermocouple.sch]
2014-02-04 Fan driver block diagram
    [BenchBudEE.sch, Fan.sch]
2014-02-08 Relay block diagram
    Relay block diagram and BenchBudEE library created
    [Arduino.sch, BenchBudEE.sch, Fan.sch, LED_Driver.sch, Power.sch, Relay.sch, TerminalBlock.sch, Thermocouple.sch]
2014-02-08 Power Protection and filtering module added
    [Arduino.sch, BenchBudEE.sch, Fan.sch, Power.sch, PowerAdjustmentMonitor.sch, Relay.sch, TerminalBlock.sch, Thermocouple.sch]
2014-02-09 Power Control Conditioning and monitoring block diagram
    [Arduino.sch, BenchBudEE.sch, Fan.sch, LED_Driver.sch, Power.sch, PowerAdjustmentMonitor.sch, Relay.sch, TerminalBlock.sch]
2014-02-09 LED Driver block diagram
    [BenchBudEE.sch, LED_Driver.sch]
2014-02-09 Arduino block diagram
    [Arduino.sch, BenchBudEE.sch, Fan.sch, LED_Driver.sch, Power.sch, PowerAdjustmentMonitor.sch, Relay.sch, TerminalBlock.sch]
2014-02-11 Fan/current module refactoring
    [Arduino.sch, BenchBudEE.sch, Fan.sch, LED_Driver.sch, Power.sch, PowerAdjustmentMonitor.sch, Relay.sch, TerminalBlock.sch]
2014-02-16 PCB Outline created and changes during components choice
    [Arduino.sch, BenchBudEE.sch, Fan.sch, LED_Driver.sch, Power.sch, PowerAdjustmentMonitor.sch, Relay.sch, TerminalBlock.sch]
2014-02-17 Associating and Placing the Relay Module
    [$Relay.sch, Arduino.sch, BenchBudEE.kicad_pcb, BenchBudEE.sch, Fan.sch, LED_Driver.sch, Power.sch, PowerAdjustmentMonitor.sch]
2014-02-22 Associating and Placingthe Thermocouple Module
    [Arduino.sch, BenchBudEE.kicad_pcb, BenchBudEE.sch, Fan.sch, LED_Driver.sch, Power.sch, PowerAdjustmentMonitor.sch, Relay.sch]
2014-02-22 Associating and Placing the Terminal Block Module
    [Arduino.sch, BenchBudEE.kicad_pcb, BenchBudEE.sch, Fan.sch, LED_Driver.sch, Power.sch, PowerAdjustmentMonitor.sch, Relay.sch]
2014-02-22 Associating and Placing Arduino Block Module
    [BenchBudEE.kicad_pcb]
2014-02-22 Associating and Placing Fan Module
    [Arduino.sch, BenchBudEE.sch, Fan.sch, LED_Driver.sch, Power.sch, PowerAdjustmentMonitor.sch, Relay.sch, TerminalBlock.sch]
2014-02-23 Associating and Placing the Power protection module
    [Arduino.sch, BenchBudEE.kicad_pcb, BenchBudEE.sch, Fan.sch, LED_Driver.sch, Power.sch, PowerAdjustmentMonitor.sch, Relay.sch]
2014-02-23 Associating and Placing the Power Modification Module
    [Arduino.sch, BenchBudEE.kicad_pcb, Fan.sch, LED_Driver.sch, Power.sch, PowerAdjustmentMonitor.sch, Relay.sch, TerminalBlock.sch]
2014-02-27 Associating and Placing the LED Driver Module
    [Arduino.sch, BenchBudEE.kicad_pcb, BenchBudEE.sch, Fan.sch, LED_Driver.sch, Power.sch, PowerAdjustmentMonitor.sch, Relay.sch]
2014-02-27 Finalizing the system part placement
    [Arduino.sch, BenchBudEE.kicad_pcb, BenchBudEE.sch, Fan.sch, LED_Driver.sch, Power.sch, PowerAdjustmentMonitor.sch, Relay.sch]
2014-03-01 Ground and Power Planes
    [Arduino.sch, BenchBudEE.kicad_pcb, BenchBudEE.sch, Fan.sch, LED_Driver.sch, Power.sch, PowerAdjustmentMonitor.sch, Relay.sch]
2014-03-01 Ground and Power Planes (after saving)
    [Arduino.sch, BenchBudEE.kicad_pcb, Fan.sch, LED_Driver.sch, Power.sch, PowerAdjustmentMonitor.sch, Relay.sch, TerminalBlock.sch]
2014-03-01 Reality Check
    [BenchBudEE.kicad_pcb, Relay.sch, TerminalBlock.sch]
2014-03-01 Layout Work Session 1
    [BenchBudEE.kicad_pcb]
2014-03-01 Layout Work Session 2
    [BenchBudEE.kicad_pcb]
2014-03-02 Layout Work Session 4
    [Arduino.sch, BenchBudEE.kicad_pcb, BenchBudEE.sch, Fan.sch, LED_Driver.sch, Power.sch, PowerAdjustmentMonitor.sch, Relay.sch]
2014-03-02 Layout Work Session 5
    [Arduino.sch, BenchBudEE.kicad_pcb, Fan.sch, Power.sch, PowerAdjustmentMonitor.sch, Relay.sch, TerminalBlock.sch, Thermocouple.sch]
2014-03-03 Layout Work Session 6
    [Arduino.sch, BenchBudEE.kicad_pcb, BenchBudEE.sch, Fan.sch, LED_Driver.sch, Power.sch, PowerAdjustmentMonitor.sch, Relay.sch]
2014-03-03 Layout Work Session 6 (II)
    [Arduino.sch, BenchBudEE.kicad_pcb, Fan.sch, LED_Driver.sch, Power.sch, PowerAdjustmentMonitor.sch, Relay.sch, TerminalBlock.sch]
2014-03-04 Layout Work Session 7
    [Arduino.sch, BenchBudEE.kicad_pcb, Fan.sch, LED_Driver.sch, Power.sch, PowerAdjustmentMonitor.sch, Relay.sch, TerminalBlock.sch]
2014-03-04 Connecting Ground Planes
    [BenchBudEE.kicad_pcb]
2014-03-05 Layout Work Session 8
    [BenchBudEE.kicad_pcb]
2014-03-05 Layout Work Session 9
    [BenchBudEE.kicad_pcb]
2014-03-08 Layout Work Session 10
    [BenchBudEE.kicad_pcb]
2014-03-13 Layout Work Session 11
    [Arduino.sch, BenchBudEE.kicad_pcb, BenchBudEE.sch, Fan.sch, LED_Driver.sch, Power.sch, PowerAdjustmentMonitor.sch, Relay.sch]
2014-03-15 Layout Work Session 12
    [Arduino.sch, BenchBudEE.kicad_pcb, BenchBudEE.sch, Fan.sch, LED_Driver.sch, Power.sch, PowerAdjustmentMonitor.sch, Relay.sch]
2014-03-16 Layout Work Session 13
    [Arduino.sch, BenchBudEE.kicad_pcb, Fan.sch, LED_Driver.sch, Power.sch, PowerAdjustmentMonitor.sch, Relay.sch, TerminalBlock.sch]
2014-03-16 Layout Work Session 14
    [Arduino.sch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]
2014-03-17 Layout Work Session 15
    [Arduino.sch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]
2014-03-17 Layout Work Session 16
    [Arduino.sch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]
2014-03-18 Layout Work Session 17
    [Arduino.sch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]
2014-03-20 Layout Work Session 18
    [$PowerAdjustmentMonitor.sch, Arduino.sch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]
2014-03-26 Analog IO Cleanup/Additions
    [$PowerAdjustmentMonitor.sch, Arduino.sch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]
2014-03-27 Changes due to external DFM
    Changes in the drill size
    [BenchBudEE-B_Cu.gbl, BenchBudEE-B_Mask.gbs, BenchBudEE-B_SilkS.gbo, BenchBudEE-Edge_Cuts.gbr, BenchBudEE-F_Cu.gtl, BenchBudEE-F_Mask.gts, BenchBudEE-F_SilkS.gto, BenchBudEE-GND.gbr]
2014-03-31 Final Changes
    [BenchBudEE-B_Cu.gbl, BenchBudEE-B_Mask.gbs, BenchBudEE-B_SilkS.gbo, BenchBudEE-Edge_Cuts.gbr, BenchBudEE-F_Cu.gtl, BenchBudEE-F_Mask.gts, BenchBudEE-F_SilkS.gto, BenchBudEE-GND.gbr]
2014-04-27 Changes for the BOM and BOMs
    [Arduino.sch, BenchBudEE.sch, BenchBudEEBOM.csv, BenchBudEEBOMPasives.csv, BenchBudEE_BOM_Actives.xls, BenchBudEE_BOM_Pasives.xls, Fan.sch, LED_Driver.sch]
